robertsonics/DaisyRogue_PCB/Robertsonics_01.jpg

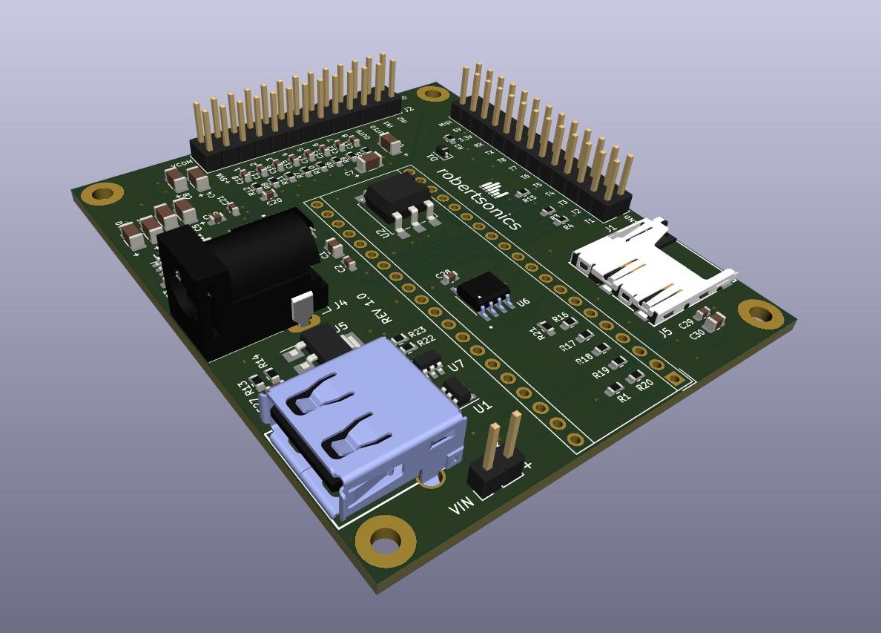
Robertsonics_01.jpg
