robertsonics/DaisyRogue_PCB/DaisyRogue.jpg

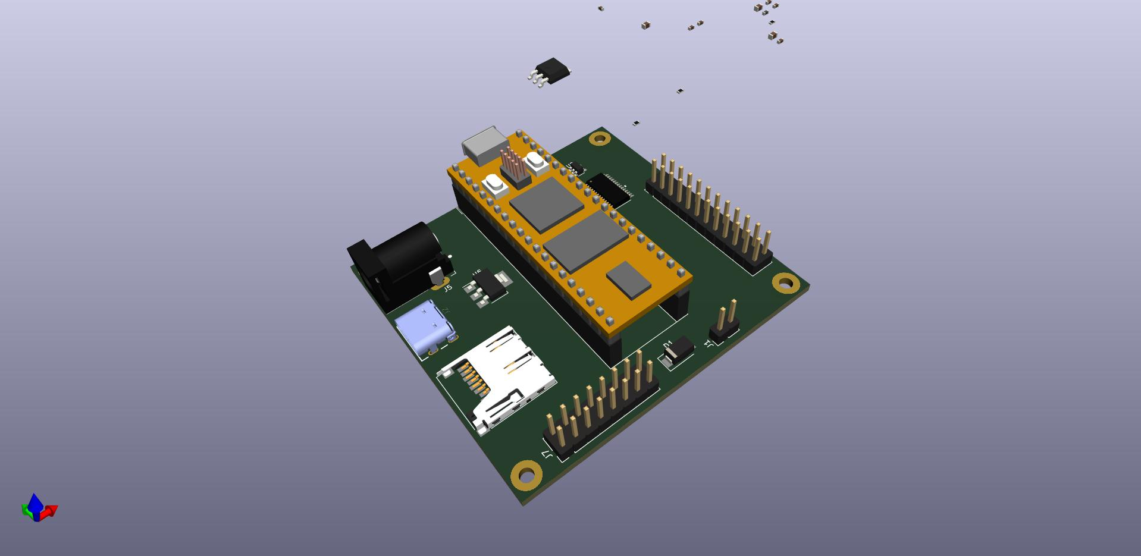
DaisyRogue.jpg
