robertsonics/DaisyRogue_PCB/README.md

# DaisyRogue_PCB
Daisy Rogue PCB KiCad Project
