robertsonics/DaisyRogue_PCB/BOM/DaisyRogue_BOM_Rev1.xlsx

Sheet: DaisyRogue
Daisy Rogue Audio Board Rev1 |  | Updated 10/31/2022
Item # | Reference | Qty | Do Not Popluate | Manufacturer Part # | Manufacturer | Value | Vendor | Vendor Part # | Price | Extended Price | DNP | Footprint | Substitution Notes
1 | A1, | 1 | DNP | Daisy Seed | ElectroSmith |  | ElectroSmith | Daisy Seed |  |  |  | DAISY SEED
 |  | 2 | DNP | PPTC201LFBN-RC | Sullins |  | Digikey | S7018-ND | $0.93 |  | $1.86 | 1x20, 0.1" Female header
2 | C1, C22, C27, C30, | 4 |  | CC0805KRX5R6BB106 | Yageo | 10uF | Digikey | 311-3424-1-ND | $0.22 | $0.88 |  | C_0805_2012Metric | >= 10V, X7R
3 | C2, C20, C21, C23, | 4 |  | C0603C105K4PAC7867 | Kemet | 1.0uF | Digikey | 399-C0603C105K4PAC7867CT-ND | $0.05 | $0.20 |  | C_0603_1608Metric | CL10B105KA8NNNL Okay
4 | C11, C12, C13, C14, C15, C16, C17, C18, | 8 |  | C1608C0G1H332J080AA | TDK | 3300pF | Digikey | 445-1599-1-N | $0.14 | $1.12 |  | C_0603_1608Metric | >=10V, <= 5%, COG/NP0
5 | C3, C4, C5, C6, C7, C8, C9, C10, | 8 |  | TL8W9226M010C | Vishay | 22uF | Digikey | 718-1917-1-ND | $0.34 | $2.72 |  | C_1206_3216Metric | >=10V, Tantalum
6 | C19, C25, | 2 |  | C0603C225K4PAC7867 | Kemet | 2.2uF | Digikey | 399-C0603C225K4PAC7867CT-ND | $0.05 | $0.10 |  | C_0603_1608Metric | >=10V, X7R
7 | C24, | 1 |  | C0603C103M5RAC7411 | Kemet | 10nF | Digikey | 399-C0603C103M5RAC7411CT-ND | $0.02 | $0.02 |  | C_0603_1608Metric | >=10V, X7R
8 | C26, C28, C29, | 3 |  | C0603C104K9PAC7867 | Kemet | 0.1uF | Digikey | 399-17575-1-ND | $0.08 | $0.24 |  | C_0603_1608Metric | >=10V
9 | D1, | 1 |  | NSR1020MW2T3G | Onsemi | D_Schottky | Digikey | NSR1020MW2T3GOSCT-ND | $0.33 | $0.33 |  | SOD-323
10 | FB1, FB2, | 2 |  | MI0603J601R-10 | Laird | 600R | Digikey | 240-2371-1-ND | $0.11 | $0.22 |  | L_0603_1608Metric | FBH160808T-601Y-S Okay
11 | R2, | 1 |  | RMCF0603JT220R | Stackpole | 220 | Digikey | RMCF0603JT220RCT-ND | $0.02 | $0.02 |  | R_0603_1608Metric | 1% - 5%
12 | R1, R3, R4, R5, R6, R7, R8, R9, R10, R11, R12 | 11 |  | RMCF0603JT2K20 | Stackpole | 2.2K | Digikey | RMCF0603JT2K20CT-ND | $0.01 | $0.11 |  | R_0603_1608Metric | 1%
13 | R13, | 1 |  | RMCF0603ZT0R00 | Stackpole | 0 | Digikey | RMCF0603ZT0R00CT-ND | $0.01 | $0.01 |  | R_0603_1608Metric | 1% - 5%
14 | R14, | 1 | DNP |  |  |  |  |  |  |  |  | R_0603_1608Metric | 1%
15 | R15, R16, R21, R22, | 4 |  | RMCF0603JT10K0 | Stackpole | 10K | Digikey | RMCF0603JT10K0CT-ND | $0.02 | $0.08 |  | R_0603_1608Metric | 1% - 5%
16 | R17, R18, R19, R20, | 4 |  | RMCF0603JT100K | Stackpole | 100K | Digikey | RMCF0603JT100KCT-ND | $0.02 | $0.08 |  | R_0603_1608Metric | 1% - 5%
17 | R23, | 1 | DNP |  |  |  |  |  |  |  |  | R_0603_1608Metric | 1% - 5%
18 | U1, | 1 |  | USBLC6-2SC6 | STMicro |  | Digikey | 497-5235-1-ND | $0.54 | $0.54 |  | SOT-23-6
19 | U2, | 1 |  | H11L1STA | Everlight |  | Digikey | 1080-1201-1-ND | $0.50 | $0.50 |  | 6-SMD
20 | U3, | 1 |  | PCM1681TPWPQ1 | TI |  | Arrow | PCM1681TPWPQ1 | $3.51 | $3.51 |  | 28-HTSSOP
21 | U4, | 1 |  | LP2985AIM5X-5.0/NOPB | TI |  | Digikey | LP2985AIM5X-5.0/NOPBCT-ND | $0.80 | $0.80 |  | SOT-23-5
22 | U5, | 1 |  | LD1117S50CTR | STMicro |  | Digikey | 497-1243-1-ND | $0.53 | $0.53 |  | SOT-223
23 | U6, | 1 |  | AT25DF256-SSHN-T | Adesto |  | Digikey | 1265-1111-1-ND | $0.50 | $0.50 |  | 8-SOIC
24 | U7, | 1 |  | STMPS2151STR | STMicro |  | Mouser | 511-STMPS2151STR | $1.00 | $1.00 |  | SOT-23-5 | STMPS2141STR Okay with resistor change
25 | P1, | 1 | DNP | USB-A1HSW6 | On Shore |  | Digikey | ED2989-ND | $0.36 |  | $0.36 | GCT_USB4105_REVA
26 | J1, J2, | 2 | DNP | PRPC013DAAN-RC | Sullins |  | Digikey | S2011EC-13-ND | $0.46 |  | $0.92 | 2x13, 0.1" Header
27 | J3 | 1 | DNP |  |  |  |  |  |  |  |  | 1x2, 0.1" Header
28 | J4, | 1 | DNP | PJ-059A | CUI |  | Digikey | CP-059A-ND | $0.68 |  | $0.68 | CUI_PJ-059A
29 | J5, | 1 |  | MEM2061-01-188-00-A | GCT |  | Digikey | 2073-MEM2061-01-188-00-ACT-ND | $1.00 | $1.00 |  | MEM2061-01-188-00-A_REVA
 |  |  |  |  |  |  |  |  |  |  | $3.82

Sheet: Annotated
Reference | Qty | Manufacturer Part # | Manufacturer | Value | Footprint | Suggested Sub
C1, C22, C27, C30, | 4 | CC0805KRX5R6BB106 | Yageo | 10uF | C_0805_2012Metric | CL21A106KAYNNNF
C2, C11, C12, C13, C14, C15, C16, C17, C18, C20, C21, C23, | 12 | C0603C105K4PAC7867 | Kemet | 1.0uF | C_0603_1608Metric | CL10B105KA8NNNL
C3, C4, C5, C6, C7, C8, C9, C10, | 8 | TL8W9226M010C | Vishay | 22uF | C_0805_2012Metric | Suggest 1206 package: 1206X226K250CG
C19, C25, | 2 | C0603C225K4PAC7867 | Kemet | 2.2uF | C_0603_1608Metric | GRM188R61E225MA12J
C24, | 1 | C0603C103M5RAC7411 | Kemet | 10nF | C_0603_1608Metric | CGA3E1C0G2A103J080AC
C26, C28, C29, | 3 | C0603C104K9PAC7867 | Kemet | 0.1uF | C_0603_1608Metric | Suggest 0402 package: CC0402KPX5R8BB104 (0603 OK too)
D1, | 1 | CPDT-5V0U-HF | Comchip | TVS DIODE 5VWM 10VC | SOT-323 | USBLC6-2SC6TR (Different package, double check specs)
D2, | 1 | SS14-E3/5AT | Vishay | D_Schottky | D_SMA | NSR1020MW2T3G (Different package, double check specs)
FB1, FB2, | 2 | MI0603J601R-10 | Laird | 600R | L_0603_1608Metric | FBH160808T-601Y-S
R2, R4, | 2 | RMCF0603JT220R | Stackpole | 220 | R_0603_1608Metric | RC0603FR-07220RL
R5, R6, R7, R8, R9, R10, R11, R12, | 8 | RMCF0603FT10K0 | Stackpole | 10, 1% | R_0603_1608Metric | CR16-10R0-FY
R13, | 1 | RMCF0603ZT0R00 | Stackpole | 0 | R_0603_1608Metric | CR16-0000-FY
R15, R16, R21, | 3 | RMCF0603JT10K0 | Stackpole | 10K | R_0603_1608Metric | RC0603FR-1310KL
R17, R18, R19, R20, | 4 | RMCF0603JT100K | Stackpole | 100K | R_0603_1608Metric | Suggest 0402 package: RC0402FR-13100KL (0603 OK too)
U1, | 1 | H11L1STA | Everlight |  | 6-SMD | H11L1SR2M
U2, | 1 | PCM1681TPWPQ1 | TI |  | 28-HTSSOP
U3, | 1 | LP2985AIM5X-5.0/NOPB | TI |  | SOT-23-5
U4, | 1 | LM1117IDT-5.0/NOPB | TI |  | TO-252-3 | LD1117S50CTR
U6, | 1 | AT25DF256-SSHN-T | Adesto |  | 8-SOIC
J5, | 1 | MEM2061-01-188-00-A | GCT |  | MEM2061-01-188-00-A_REVA
