robertsonics/DaisyRogue_PCB/DaisyRogue.kicad_pcb

## KiCad design DaisyRogue.kicad_pcb (2023-03-04)

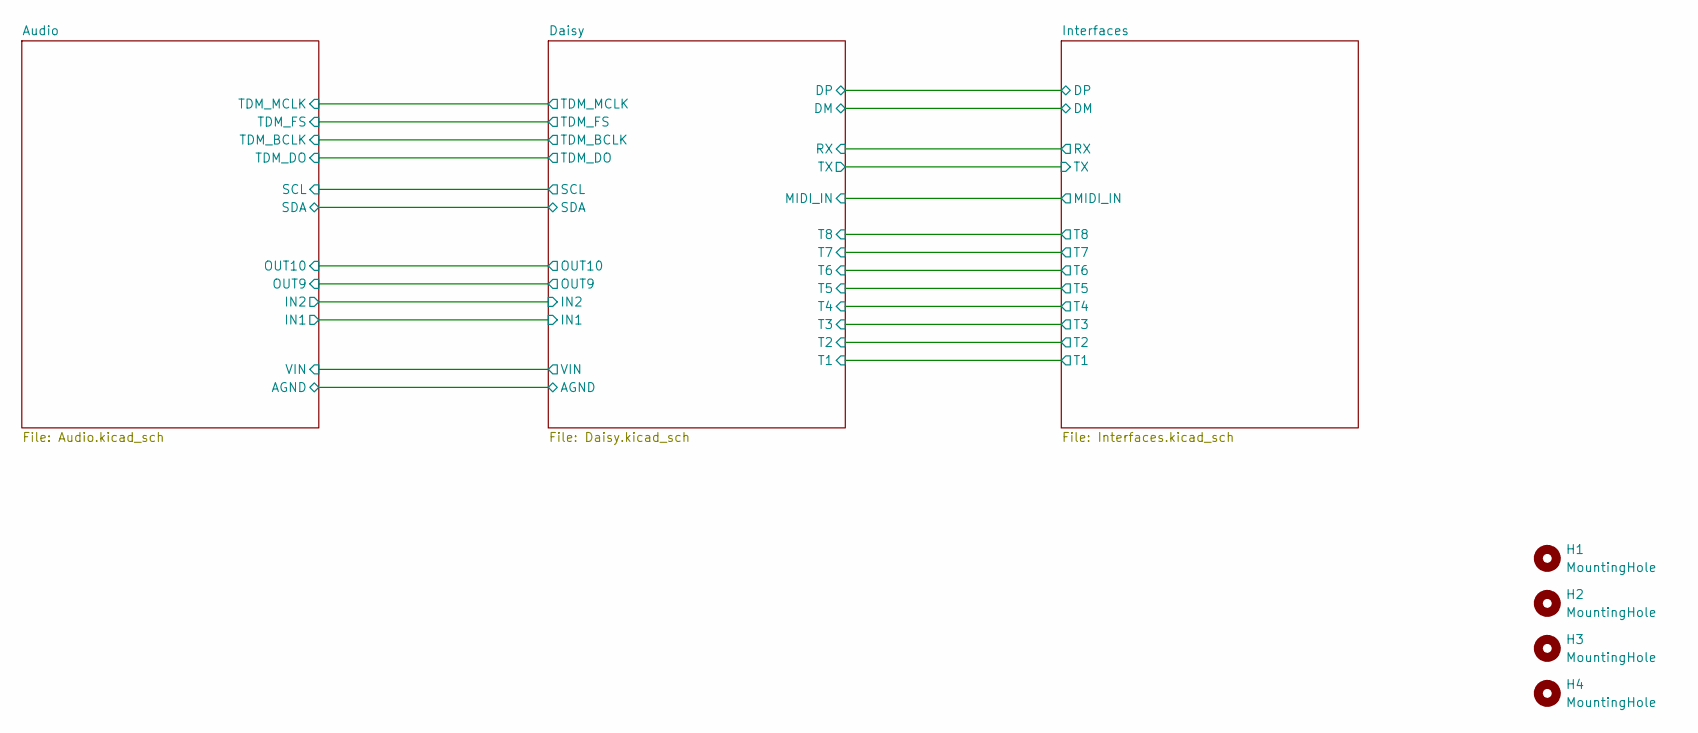
[picture p7: schematic DaisyRogue.kicad_sch, Daisy Rogue]

Parts:
H1, H2, H3, H4: MountingHole; MountingHole_2.7mm_Pad_TopBottom

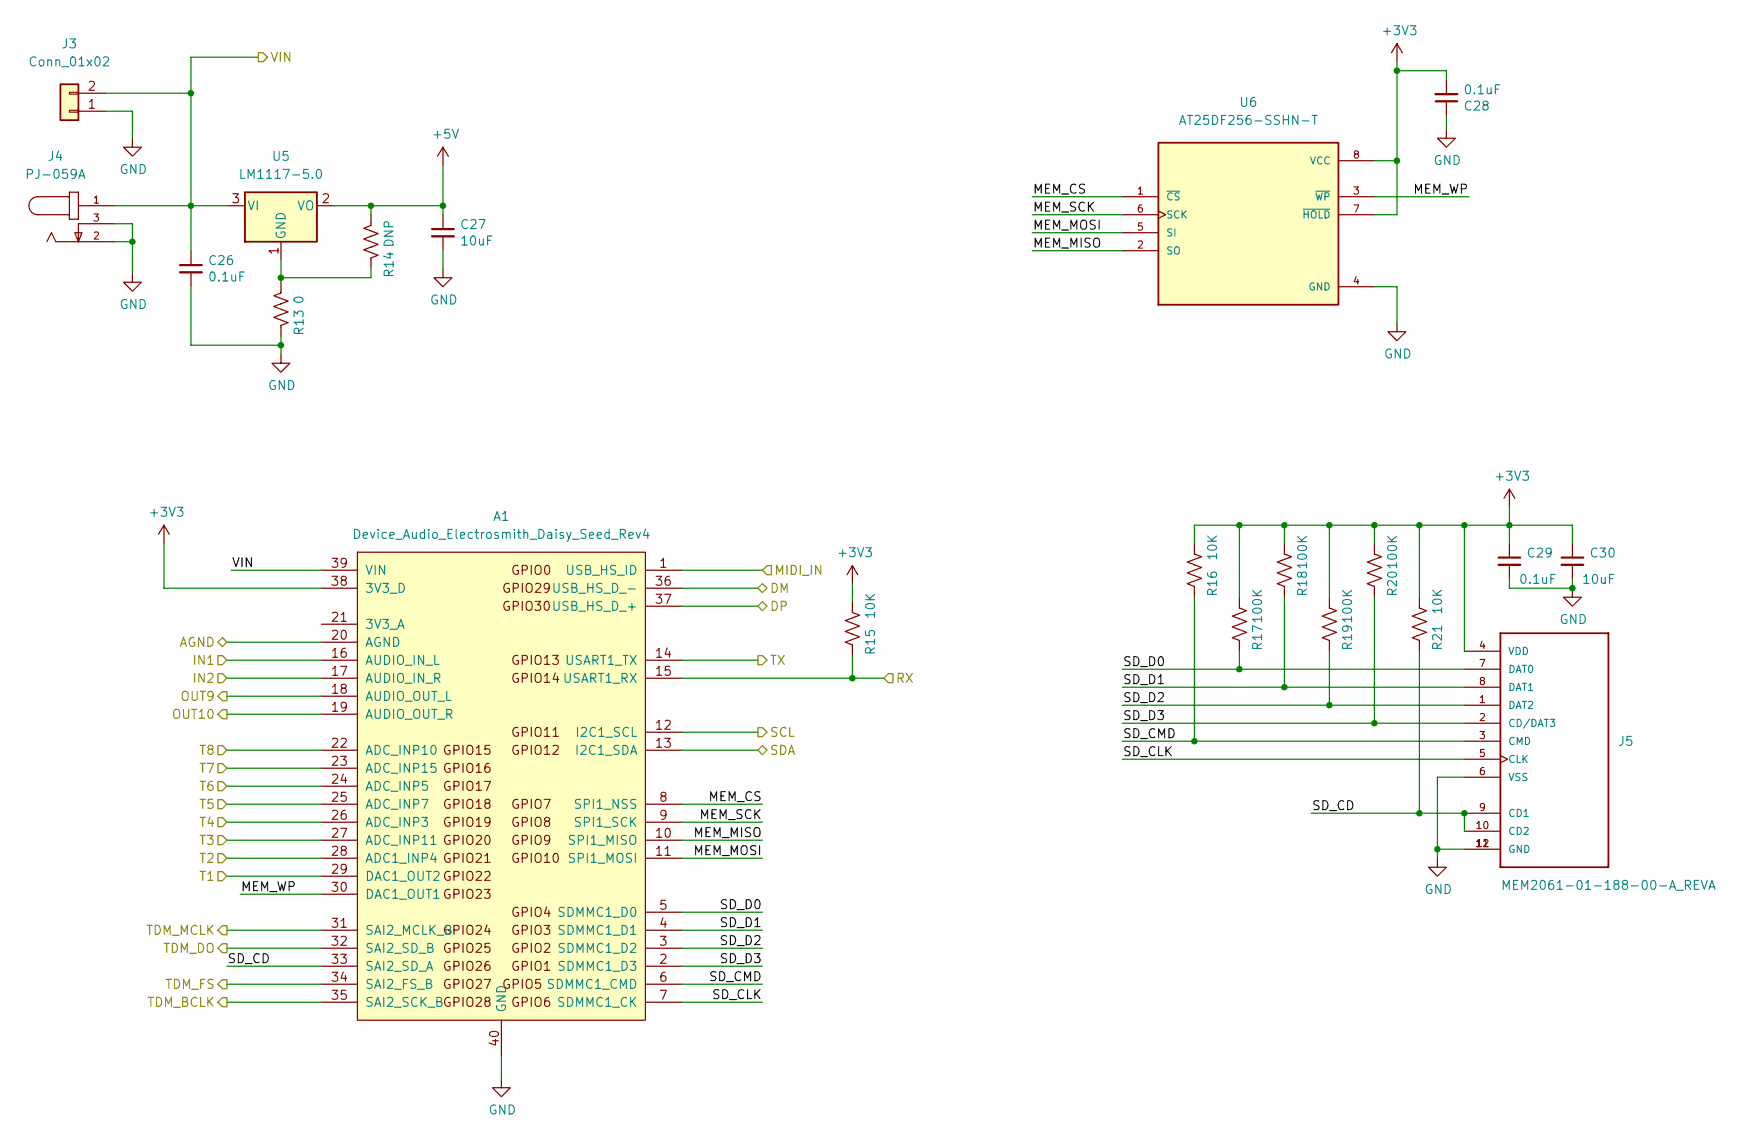
[picture p8: schematic Daisy.kicad_sch, Daisy Rogue]

Parts:
A1: Device_Audio_Electrosmith_Daisy_Seed_Rev4; Device_Audio_Electrosmith_Daisy_Seed
C26, C28, C29: 0.1uF; C_0603_1608Metric
C27, C30: 10uF; C_0805_2012Metric
J3: Conn_01x02; PinHeader_1x02_P2.54mm_Vertical
J4: PJ-059A; CUI_PJ-059A; PARTREV 1.02
J5: MEM2061-01-188-00-A_REVA
R13: 0; R_0603_1608Metric
R14: DNP; R_0603_1608Metric
R15, R16, R21: 10K; R_0603_1608Metric
R17, R18, R19, R20: 100K; R_0603_1608Metric
U5: LM1117-5.0; SOT-223-3_TabPin2
U6: AT25DF256-SSHN-T; SOIC127P599X175-8N; PARTREV 5/2017

Connections:
+3V3: A1.38 (3V3_D), C28.2, C29.1, C30.1, J5.4 (VDD), R15.1, R16.1, R17.1, R18.1, R19.1, R20.1, R21.1, U6.7 (~HOLD), U6.8 (VCC); also elsewhere on the board
+5V: C27.1, R14.2, U5.2 (VO); also elsewhere on the board
/Audio/IN1: A1.16 (AUDIO_IN_L); also elsewhere on the board
/Audio/IN2: A1.17 (AUDIO_IN_R); also elsewhere on the board
/Audio/OUT9: A1.18 (AUDIO_OUT_L); also elsewhere on the board
/Audio/OUT10: A1.19 (AUDIO_OUT_R); also elsewhere on the board
/Audio/SCL: A1.12 (I2C1_SCL); also elsewhere on the board
/Audio/SDA: A1.13 (I2C1_SDA); also elsewhere on the board
/Audio/TDM_BCLK: A1.35 (SAI2_SCK_B); also elsewhere on the board
/Audio/TDM_DO: A1.32 (SAI2_SD_B); also elsewhere on the board
/Audio/TDM_FS: A1.34 (SAI2_FS_B); also elsewhere on the board
/Audio/TDM_MCLK: A1.31 (SAI2_MCLK_B); also elsewhere on the board
/Daisy/DM: A1.36 (USB_HS_D_-); also elsewhere on the board
/Daisy/DP: A1.37 (USB_HS_D_+); also elsewhere on the board
/Daisy/MEM_CS: A1.8 (SPI1_NSS), U6.1 (~CS)
/Daisy/MEM_MISO: A1.10 (SPI1_MISO), U6.2 (SO)
/Daisy/MEM_MOSI: A1.11 (SPI1_MOSI), U6.5 (SI)
/Daisy/MEM_SCK: A1.9 (SPI1_SCK), U6.6 (SCK)
/Daisy/MEM_WP: A1.30 (DAC1_OUT1), U6.3 (~WP)
/Daisy/MIDI_IN: A1.1 (USB_HS_ID); also elsewhere on the board
/Daisy/RX: A1.15 (USART1_RX), R15.2; also elsewhere on the board
/Daisy/SD_CD: A1.33 (SAI2_SD_A), J5.9 (CD1), J5.10 (CD2), R21.2
/Daisy/SD_CLK: A1.7 (SDMMC1_CK), J5.5 (CLK)
/Daisy/SD_CMD: A1.6 (SDMMC1_CMD), J5.3 (CMD), R16.2
/Daisy/SD_D0: A1.5 (SDMMC1_D0), J5.7 (DAT0), R17.2
/Daisy/SD_D1: A1.4 (SDMMC1_D1), J5.8 (DAT1), R18.2
/Daisy/SD_D2: A1.3 (SDMMC1_D2), J5.1 (DAT2), R19.2
/Daisy/SD_D3: A1.2 (SDMMC1_D3), J5.2 (CD/DAT3), R20.2
/Daisy/T1: A1.29 (DAC1_OUT2); also elsewhere on the board
/Daisy/T2: A1.28 (ADC1_INP4); also elsewhere on the board
/Daisy/T3: A1.27 (ADC_INP11); also elsewhere on the board
/Daisy/T4: A1.26 (ADC_INP3); also elsewhere on the board
/Daisy/T5: A1.25 (ADC_INP7); also elsewhere on the board
/Daisy/T6: A1.24 (ADC_INP5); also elsewhere on the board
/Daisy/T7: A1.23 (ADC_INP15); also elsewhere on the board
/Daisy/T8: A1.22 (ADC_INP10); also elsewhere on the board
/Daisy/TX: A1.14 (USART1_TX); also elsewhere on the board
/Daisy/VIN: A1.39 (VIN), C26.1, J3.2, J4.1, U5.3 (VI); also elsewhere on the board
GND: A1.40 (GND), C26.2, C27.2, C28.1, C29.2, C30.2, J3.1, J4.2, J4.3, J5.6 (VSS), J5.11 (GND), J5.12 (GND), R13.2, U6.4 (GND); also elsewhere on the board
GNDA: A1.20 (AGND); also elsewhere on the board
unnamed: R13.1, R14.1, U5.1 (GND)

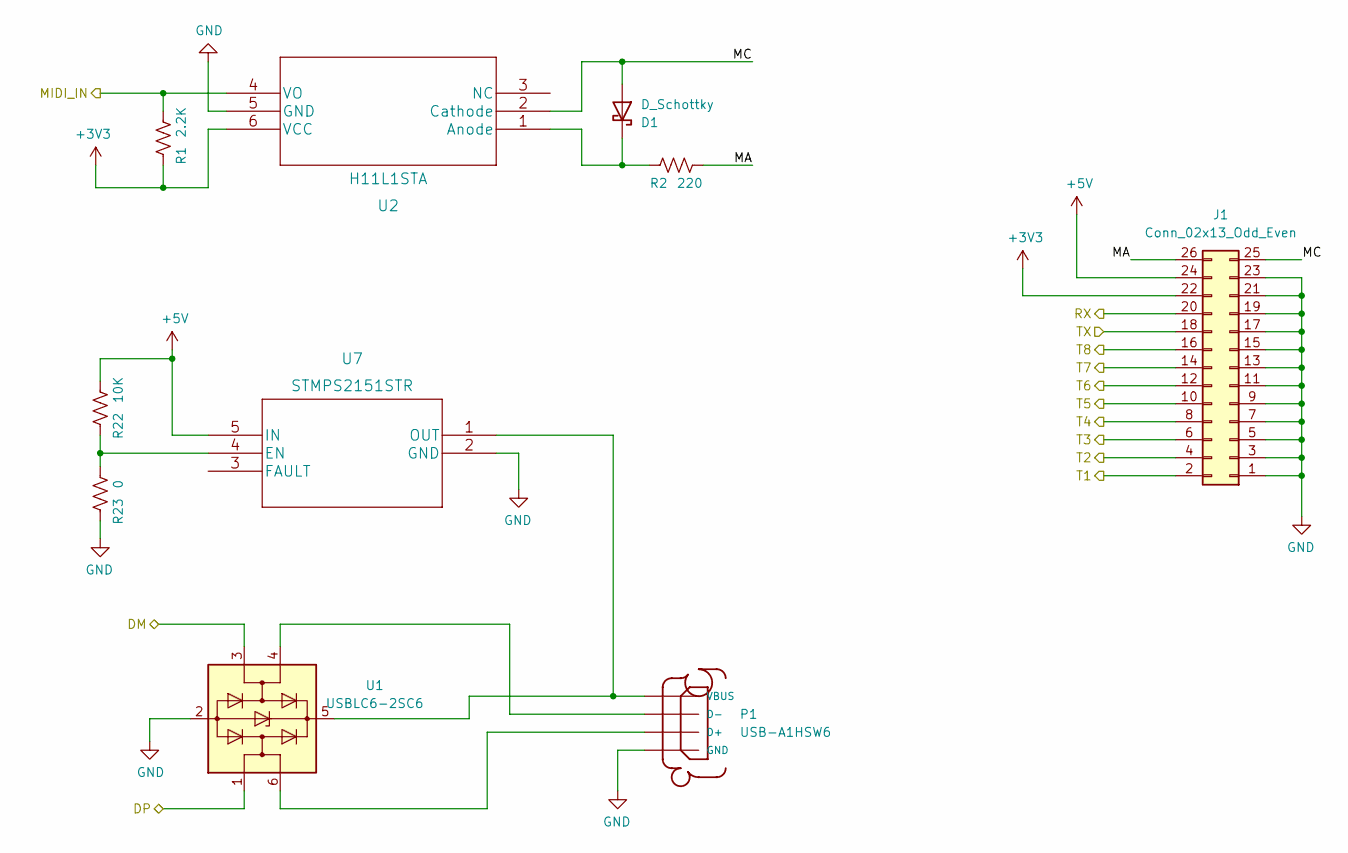
[picture p9: schematic Interfaces.kicad_sch, Daisy Rogue]

Parts:
D1: D_Schottky; D_SOD-323
J1: Conn_02x13_Odd_Even; PinHeader_2x13_P2.54mm_Vertical
P1: USB-A1HSW6; OST_USB-A1HSW6
R1: 2.2K; R_0603_1608Metric
R2: 220; R_0603_1608Metric
R22: 10K; R_0603_1608Metric
R23: 0; R_0603_1608Metric
U1: USBLC6-2SC6; SOT-23-6
U2: H11L1STA
U7: STMPS2151STR; SOT-23-5

Connections:
+3V3: J1.22, R1.2, U2.6 (VCC); also elsewhere on the board
+5V: J1.24, R22.1, U7.5 (IN); also elsewhere on the board
/Daisy/DM: U1.3 (I/O2); also elsewhere on the board
/Daisy/DP: U1.1 (I/O1); also elsewhere on the board
/Daisy/MIDI_IN: R1.1, U2.4 (VO); also elsewhere on the board
/Daisy/RX: J1.20; also elsewhere on the board
/Daisy/T1: J1.2; also elsewhere on the board
/Daisy/T2: J1.4; also elsewhere on the board
/Daisy/T3: J1.6; also elsewhere on the board
/Daisy/T4: J1.8; also elsewhere on the board
/Daisy/T5: J1.10; also elsewhere on the board
/Daisy/T6: J1.12; also elsewhere on the board
/Daisy/T7: J1.14; also elsewhere on the board
/Daisy/T8: J1.16; also elsewhere on the board
/Daisy/TX: J1.18; also elsewhere on the board
/Interfaces/MA: J1.26, R2.1
/Interfaces/MC: D1.2 (A), J1.25, U2.2 (Cathode)
GND: J1.1, J1.3, J1.5, J1.7, J1.9, J1.11, J1.13, J1.15, J1.17, J1.19, J1.21, J1.23, P1.4 (GND), R23.2, U1.2 (GND), U2.5 (GND), U7.2 (GND); also elsewhere on the board
unnamed: D1.1 (K), R2.2, U2.1 (Anode)
unnamed: P1.1 (VBUS), U1.5 (VBUS), U7.1 (OUT)
unnamed: P1.2 (D-), U1.4 (I/O2)
unnamed: P1.3 (D+), U1.6 (I/O1)
unnamed: R22.2, R23.1, U7.4 (EN)

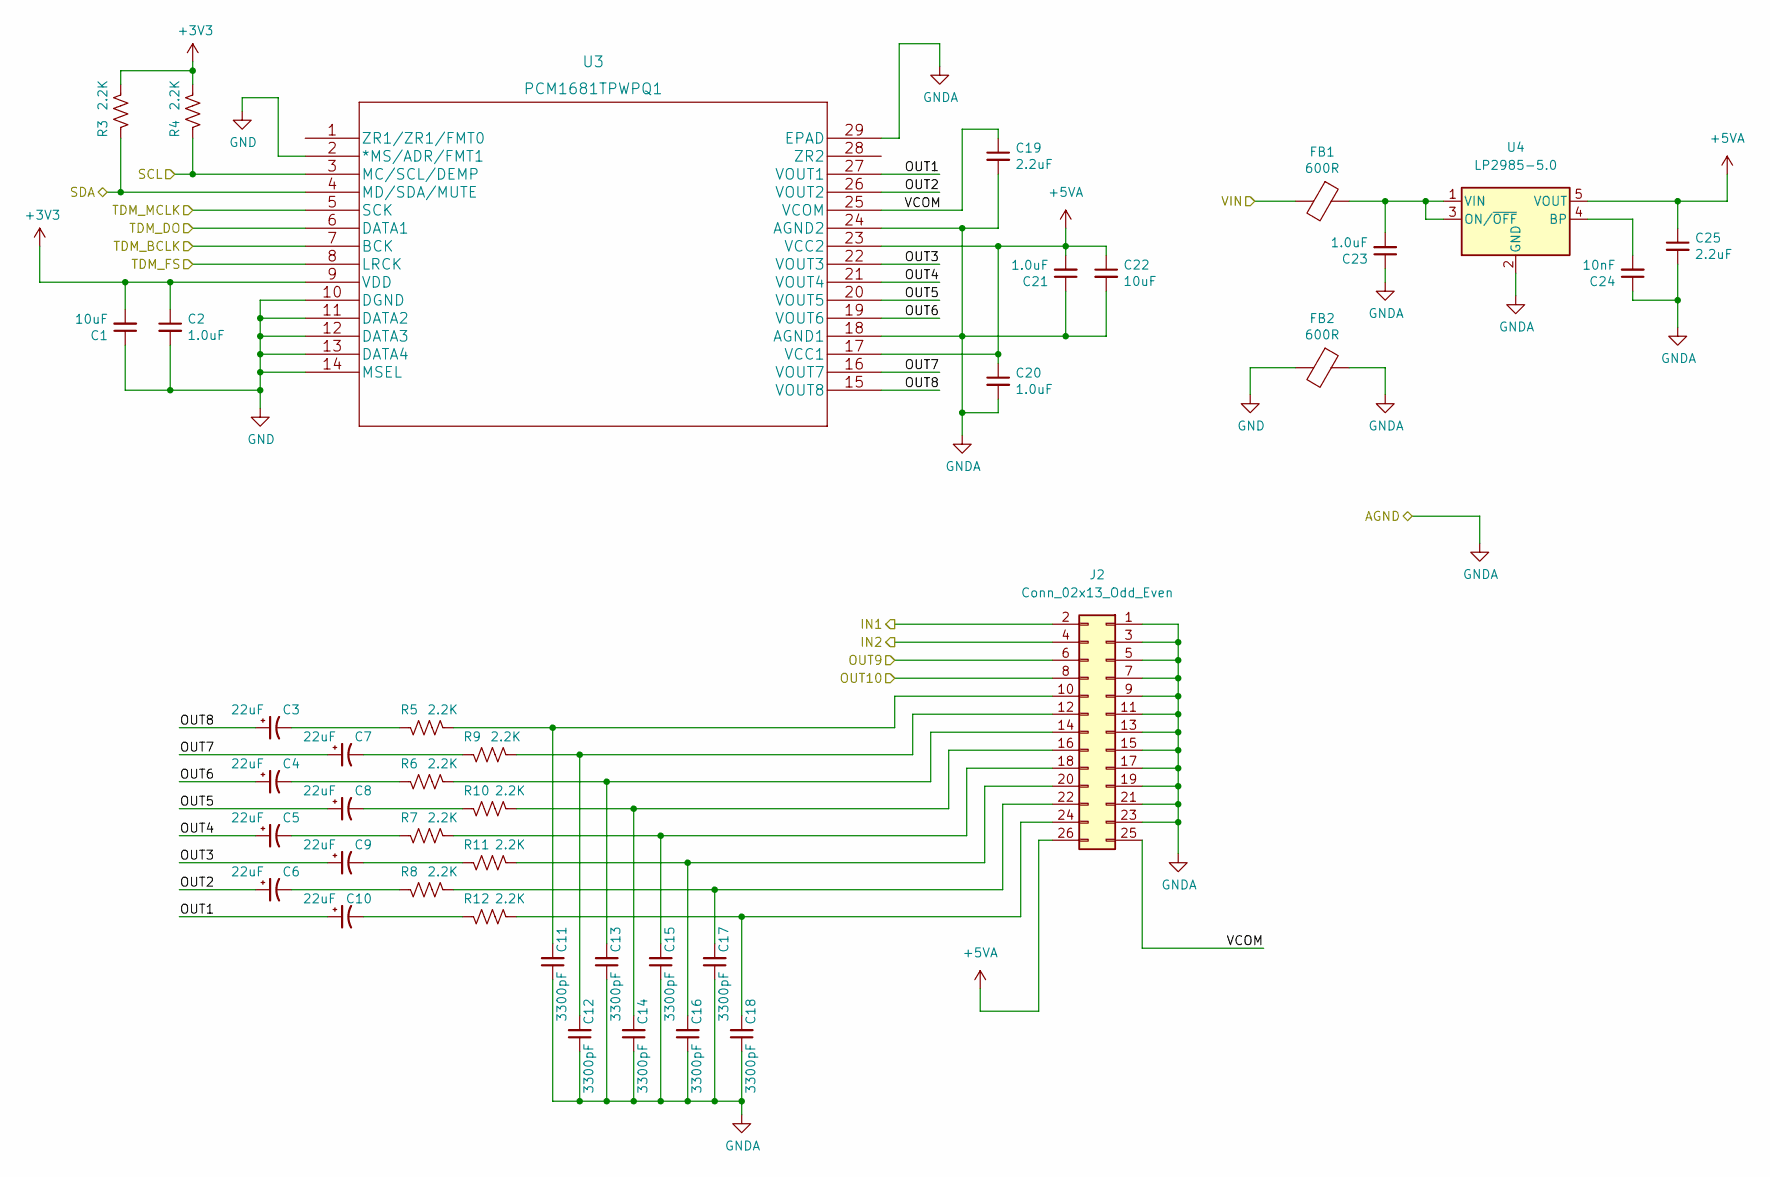
[picture p10: schematic Audio.kicad_sch, Daisy Rogue]

Parts:
C1, C22: 10uF; C_0805_2012Metric
C2, C20, C21, C23: 1.0uF; C_0603_1608Metric
C3, C4, C5, C6, C7, C8, C9, C10: 22uF; C_1206_3216Metric
C11, C12, C13, C14, C15, C16, C17, C18: 3300pF; C_0603_1608Metric
C19, C25: 2.2uF; C_0603_1608Metric
C24: 10nF; C_0603_1608Metric
FB1, FB2: 600R; L_0603_1608Metric
J2: Conn_02x13_Odd_Even; PinHeader_2x13_P2.54mm_Vertical
R3, R4, R5, R6, R7, R8, R9, R10, R11, R12: 2.2K; R_0603_1608Metric
U3: PCM1681TPWPQ1
U4: LP2985-5.0; SOT-23-5

Connections:
+3V3: C1.2, C2.1, R3.1, R4.1, U3.9 (VDD); also elsewhere on the board
+5VA: C20.1, C21.2, C22.1, C25.1, J2.26, U3.17 (VCC1), U3.23 (VCC2), U4.5 (VOUT)
/Audio/IN1: J2.2; also elsewhere on the board
/Audio/IN2: J2.4; also elsewhere on the board
/Audio/OUT1: C10.1, U3.27 (VOUT1)
/Audio/OUT2: C6.1, U3.26 (VOUT2)
/Audio/OUT3: C9.1, U3.22 (VOUT3)
/Audio/OUT4: C5.1, U3.21 (VOUT4)
/Audio/OUT5: C8.1, U3.20 (VOUT5)
/Audio/OUT6: C4.1, U3.19 (VOUT6)
/Audio/OUT7: C7.1, U3.16 (VOUT7)
/Audio/OUT8: C3.1, U3.15 (VOUT8)
/Audio/OUT9: J2.6; also elsewhere on the board
/Audio/OUT10: J2.8; also elsewhere on the board
/Audio/SCL: R4.2, U3.3 (MC/SCL/DEMP); also elsewhere on the board
/Audio/SDA: R3.2, U3.4 (MD/SDA/MUTE); also elsewhere on the board
/Audio/TDM_BCLK: U3.7 (BCK); also elsewhere on the board
/Audio/TDM_DO: U3.6 (DATA1); also elsewhere on the board
/Audio/TDM_FS: U3.8 (LRCK); also elsewhere on the board
/Audio/TDM_MCLK: U3.5 (SCK); also elsewhere on the board
/Audio/VCOM: C19.1, J2.25, U3.25 (VCOM)
/Daisy/VIN: FB1.2; also elsewhere on the board
GND: C1.1, C2.2, FB2.2, U3.2 (*MS/ADR/FMT1), U3.10 (DGND), U3.11 (DATA2), U3.12 (DATA3), U3.13 (DATA4), U3.14 (MSEL); also elsewhere on the board
GNDA: C11.1, C12.1, C13.1, C14.1, C15.1, C16.1, C17.1, C18.1, C19.2, C20.2, C21.1, C22.2, C23.1, C24.1, C25.2, FB2.1, J2.1, J2.3, J2.5, J2.7, J2.9, J2.11, J2.13, J2.15, J2.17, J2.19, J2.21, J2.23, U3.18 (AGND1), U3.24 (AGND2), U3.29 (EPAD), U4.2 (GND); also elsewhere on the board
unnamed: C3.2, R5.2
unnamed: C4.2, R6.2
unnamed: C5.2, R7.2
unnamed: C6.2, R8.2
unnamed: C7.2, R9.2
unnamed: C8.2, R10.2
unnamed: C9.2, R11.2
unnamed: C10.2, R12.2
unnamed: C11.2, J2.10, R5.1
unnamed: C12.2, J2.12, R9.1
unnamed: C13.2, J2.14, R6.1
unnamed: C14.2, J2.16, R10.1
unnamed: C15.2, J2.18, R7.1
unnamed: C16.2, J2.20, R11.1
unnamed: C17.2, J2.22, R8.1
unnamed: C18.2, J2.24, R12.1
unnamed: C23.2, FB1.1, U4.1 (VIN), U4.3 (ON/~OFF)
unnamed: C24.2, U4.4 (BP)

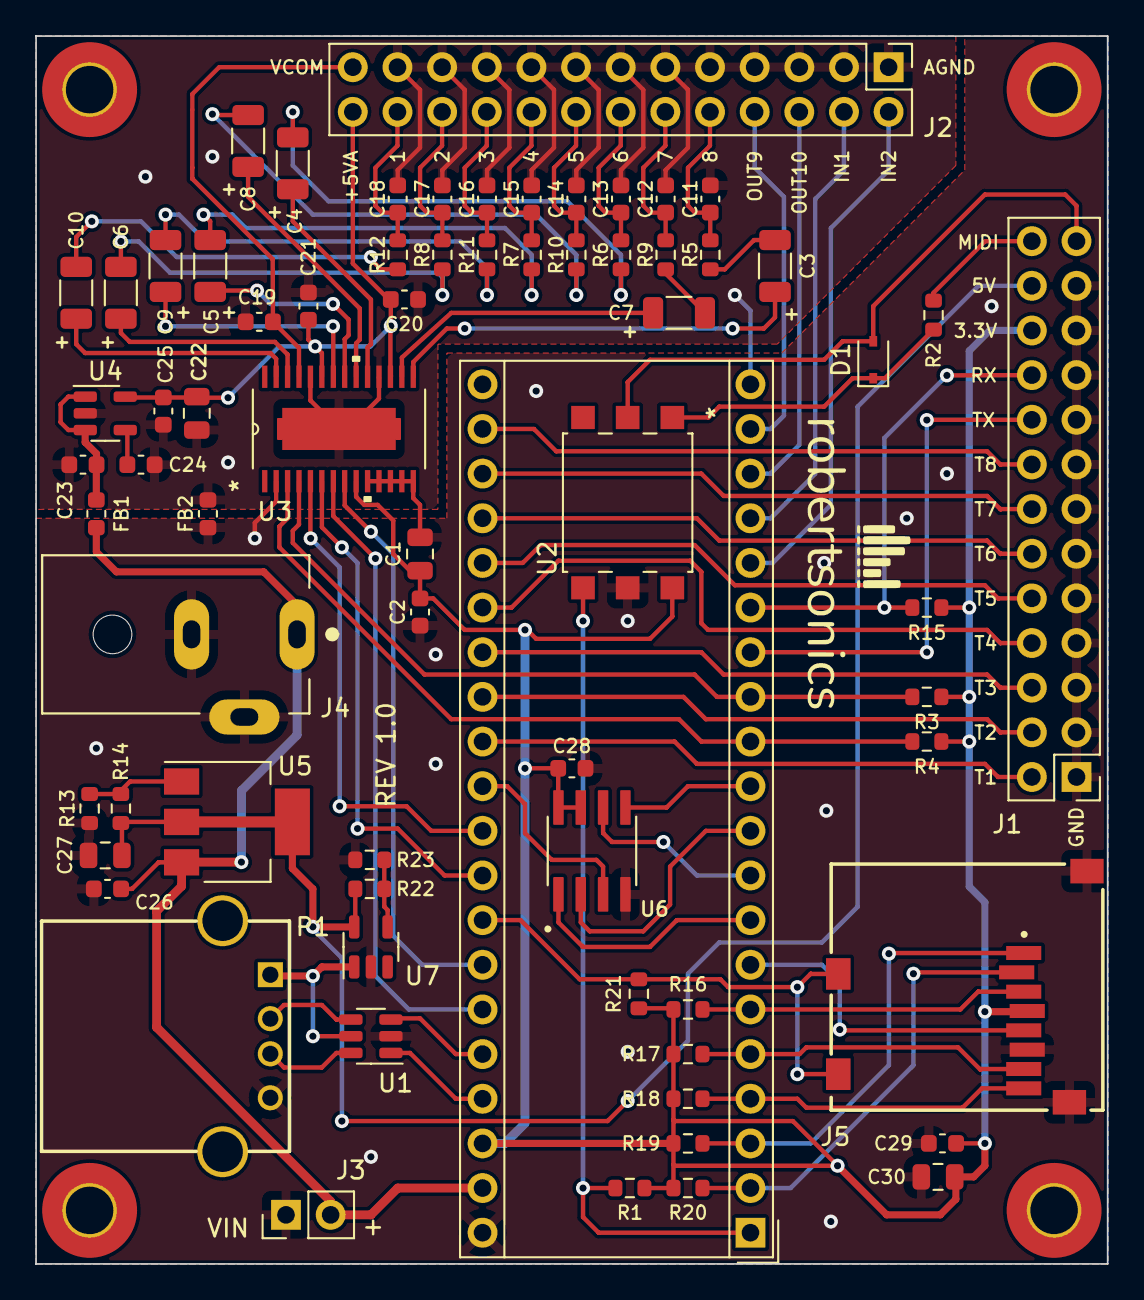
[picture p11: board DaisyRogue.kicad_pcb from above]

Board: 2 copper layers, 61.0 x 69.8 mm, 74 parts (0 on the bottom side), 76 nets.
